Ultramarine3D/Ultramarine/business_materials/img/eva3.png

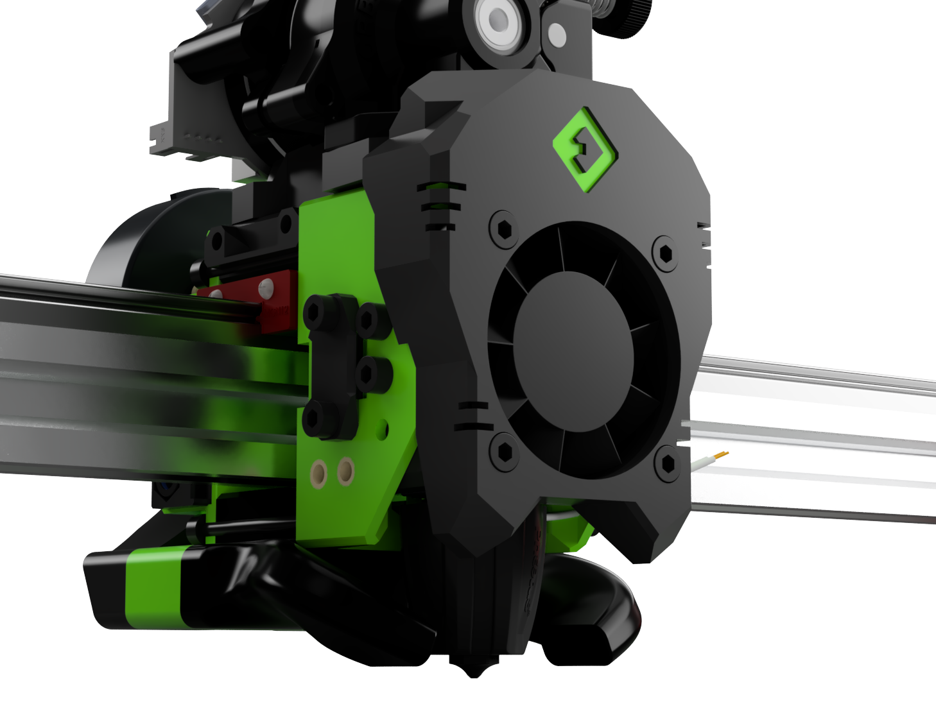
business_materials/img/eva3.png
