Ultramarine3D/Ultramarine/README.md

# Ultramarine
A custom CoreXY 3D printer.

Site:
https://github.com/Ultramarine3D/Ultramarine

https://grabcad.com/library 
https://www.mcmaster.com/

Useful guides:
https://github.com/bigtreetech/Manta-M8P
https://github.com/bigtreetech/EBB
https://www.klipper3d.org/
https://canbus.esoterical.online/
https://main.eva-3d.page/
https://all3dp.com/1/common-3d-printing-problems-troubleshooting-3d-printer-issues/

https://creativecommons.org/licenses/by-nc/4.0/
