Ultramarine3D/Ultramarine/firmware/firmware_here.md

# Firmware for the Ultramarine 3D printer
