Ultramarine3D/Ultramarine/STLs/stls_here.md

# STL for printed parts
## All STL's for printed parts on the Ultramarine 3D printer
___
## IF A PART IS LISTED HERE BUT NOT IN THE REPO, PLEASE CREATE AN ISSUE AND I WILL ADD IT TO THE REPO.
YOU CAN ALSO EXPORT THE PART DIRECTLY FROM THE .F3Z FILE AND ADD IT TO THE REPO. 

## Print Settings % Materials
These parts are ideally printed in PETG, PTCG, ABS, ASA or ideally PC for strength and heat resistance. (Glass or Carbon fiber filled versions of these filaments are also good options for strength and heat resistance.)

Nozzle: 0.4mm
Layer height: 0.2mm
Walls: 4-5 walls
Top/Bottom layers: 4-5 layers
Infill: 35-45%
Infill pattern: Gyroid, Cubic, Adaptive Cubic, or similar

___
## List of printed parts
Printed parts list:

**XY:**
- Front left motor mount top: `front_left_motor_mount.stl` — Stepper motor mount for X/Y axis.
- Front left motor mount bottom: `front_left_motor_mount.stl` — Stepper motor mount for X/Y axis.x    
- Front right motor mount top: `front_right_motor_mount.stl` — Stepper motor mount for X/Y axis.
- Front right motor mount bottom: `front_right_motor_mount.stl` — Stepper motor mount for X/Y axis.

- Rear left idler mount top: `rear_left_idler_mount.stl` — Idler mount for X/Y axis.
- Rear left idler mount bottom: `rear_left_idler_mount.stl` — Idler mount for X/Y axis.
- Rear right idler mount top: `rear_right_idler_mount.stl` — Idler mount for X/Y axis.
- Rear right idler mount bottom: `rear_right_idler_mount.stl` — Idler mount for X/Y axis.

- X axis mount left top: `x_axis_mount_left.stl` — Mount for X axis
- X axis mount left bottom: `x_axis_mount_left_bottom.stl` — Mount for X axis
- X axis mount right top: `x_axis_mount_right.stl` — Mount for X axis
- X axis mount right bottom: `x_axis_mount_right_bottom.stl` — Mount for X axis

**Z:**
- WobbleX: `wobble_x.stl` — WobbleX mount for Z axis.
- WobbleX spacer: `wobble_x_spacer.stl` — Spacer for WobbleX mount.
- Left Linear rail, ball screw & bed mount: `linear_rail_ballscrew_bed_mount.stl` — Mount for linear rail, ball screw, and bed.
- Right Linear rail, ball screw & bed mount: `linear_rail_ballscrew_bed_mount_right.stl` — Mount for linear rail, ball screw, and bed.
- Rear Linear rail, ball screw & bed mount: `linear_rail_ballscrew_bed_mount_rear.stl` — Mount for linear rail, ball screw, and bed.
- Left Z motor mount: `z_motor_mount_left.stl` — Stepper motor mount for Z axis.
- Right Z motor mount: `z_motor_mount_right.stl` — Stepper motor mount
- Rear Z motor mount: `z_motor_mount_rear.stl` — Stepper motor mount for Z axis.  
- Left Ball screw stabilizer: `ball_screw_stabilizer.stl` — Stabilizes ball screw for Z axis.
- Right Ball screw stabilizer: `ball_screw_stabilizer_right.stl` — Stabilizes ball screw for Z axis.
- Rear Ball screw stabilizer: `ball_screw_stabilizer_rear.stl` — Stabilizes ball screw for Z axis.

**Toolhead:**
- Eva3 with following mods:
- klicky probe mount design from printables.com
- ebb36 mount + wire guard (original design from printables.com)
- Klicky probe mount: `klicky_probe_mount.stl` — Mount for Klicky probe.

**Electronics area:**
- Cover 1: `electronics_cover_1.stl` — Covers electronics area. (Front panel cover)
- Cover 2: `electronics_cover_2.stl` — Covers electronics area. (Front panel cover)
- Cover 3: `electronics_cover_3.stl` — Covers electronics area. (Front panel cover)
- Cover 4: `electronics_cover_4.stl` — Covers electronics area. (Front panel cover)
- Cover 5: `electronics_cover_5.stl` — Covers electronics area. (Left side cover)
- Cover 6: `electronics_cover_6.stl` — Covers electronics area. (Left side cover)
- Cover 7: `electronics_cover_7.stl` — Covers electronics area. (Left side cover)
- Cover 8: `electronics_cover_8.stl` — Covers electronics area. (Left side cover)
- Cover 9: `electronics_cover_9.stl` — Covers electronics area. (Right side cover)
- Cover 10: `electronics_cover_10.stl` — Covers electronics area. (Right side cover)
- Cover 11: `electronics_cover_11.stl` — Covers electronics area. (Right side cover)
- Cover 12: `electronics_cover_12.stl` — Covers electronics area. (Right side cover)
- Cover 13: `electronics_cover_13.stl` — Covers electronics area. (Rear side cover)
- Cover 14: `electronics_cover_14.stl` — Covers electronics area. (Rear side cover)
- Cover 15: `electronics_cover_15.stl` — Covers electronics area. (Rear side cover)
- Cover 16: `electronics_cover_16.stl` — Covers electronics area. (Rear side cover)
- Din to 3030 rail mount: `din_3030_mount.stl` — Mounts DIN rail to 3030 extrusion.

**Others:**
- Feet / leveling foot: `printer_foot.stl` — Felt-screw printer feet.
- LCD cover: `printables — Mount for front panel or display. (By derebbe - printables.com)
- LCD mount 1: `lcd_mount.stl` — Secures LCD or touchscreen to frame.
- LCD mount 2: `lcd_mount_2.stl` — Secures LCD or touchscreen to frame.
- Cable chain mount: `cable_chain_mount.stl` — Mounts cable chain to frame.
- Cable chain mount 2: `cable_chain_mount_2.stl` — Mounts cable chain to frame.
- Enclosure panel mount: `enclosure_panel_mount.stl` — Mounts enclosure panels to frame.
- Enclosure Door handle 1: `enclosure_door_handle_1.stl` — Handle for enclosure door.
- Enclosure Door handle 2: `enclosure_door_handle_2.stl` — Handle for enclosure door.
- Enclosure Door hinges: `enclosure_door_hinges.stl` — Hinges for enclosure door. - Print in place, design from NJNEER (original by E. Soderberg ) modified by me.
