Ultramarine3D/Ultramarine/business_materials/img/FFF-3D-tlaciaren.PNG

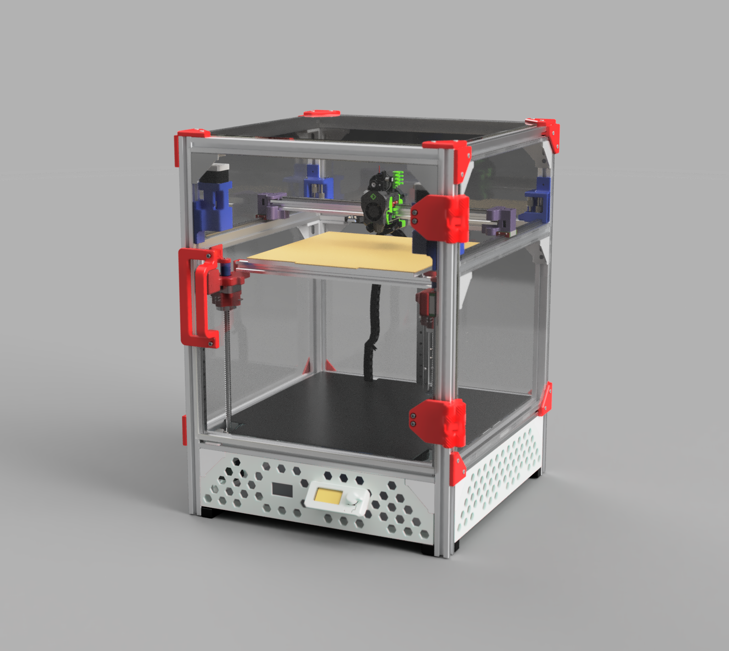
business_materials/img/FFF-3D-tlaciaren.PNG
