Ultramarine3D/Ultramarine/business_materials/img/UM3DCoreXY v82.png

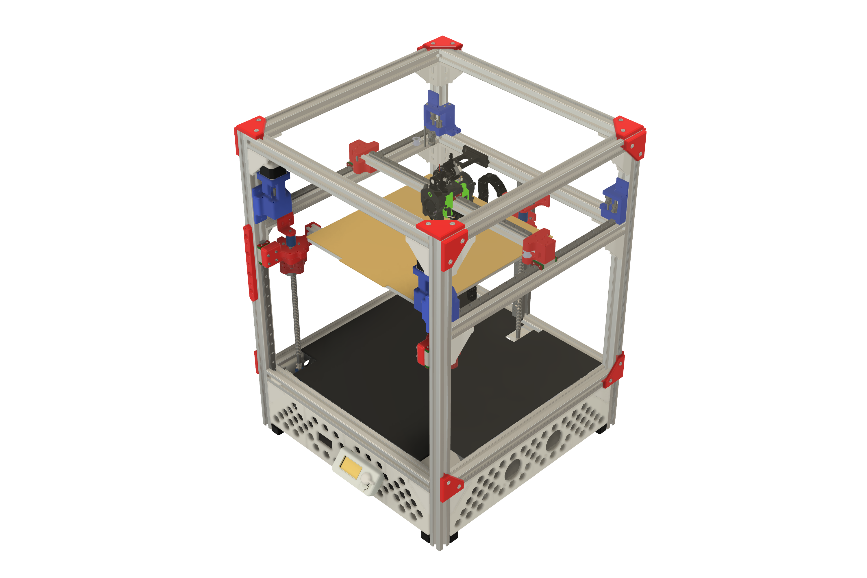
business_materials/img/UM3DCoreXY v82.png
