Ultramarine3D/Ultramarine/(list of files, cad)

Other CAD files:
cad/UM3DCoreXY.step
cad/UM3DCoreXY.f3z
