Ultramarine3D/Ultramarine/(commit log)

2026-07-29 Initial clean commit
    [archive_printer.cfg, old.cfg, printer.cfg, start_print.cfg]
2026-07-29 Add CAD model
    [UM3DCoreXY.step]
2026-07-29 Add F3Z CAD file
    [UM3DCoreXY.f3z]
2026-09-04 Add combined Ultramarine complete manual
    Merges UM3DCoreXY_Build_Guide.md and UM3DCoreXY_Troubleshooting_Guide.md
    into a single manual, written for SPSE Halova 16 students whose only prior
    experience is a Prusa Mini.
    Reconciled against the live printer.cfg, which won wherever the two source
    guides disagreed with it. Two of those disagreements were substantive:
    - The old troubleshooting guide specified rotation_distance 8 for a T8
    leadscrew. The machine uses a 1204 ballscrew at rotation_distance 4;
    following the old text halves every Z dimension.
    - Both guides referred to START_PRINT/END_PRINT. The config defines
    PRINT_START/PRINT_END, so the old names in a slicer meant the macro
    si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
